swissinnovationlab/hardware_stm32_s3220/README.md

# hardware_stm32_s3220
STM32 based motherboard for AEDT
