swissinnovationlab/hardware_stm32_s3220/S3220B/Documentation/BOM S3220B(S3220B_A) 220808.xls

Bill of Materials |  |  | Swiss Innovation Lab+
Source Data From: |  | S3220B.PrjPcb
Project: |  | S3220B.PrjPcb
Variant: |  | S3220B_A
Creation Date: | 17/09/2021 | 16:08
Print Date: | 2022-08-09 | 12:21:25
Production Quantity: | 1
Currency | USD
Designator |  | Comment | Description | Footprint | Quantity | Supplier 1 | Supplier Part Number 1 | Currency | Price | Price per board
C1, C2, C7, C8, C10, C12, C14, C16, C18, C20, C23, C25, C29, C33, C41, C43, C44, C45, C47, C49, C50, C52, C53, C55, C56, C57, C58 |  | 100nF_50V | 0.1µF ±10% 50V Ceramic Capacitor X7R 0603 (1608 Metric) | C_0603 | 27 | Digi-Key | 445-1314-6-ND | $ | 0,01309 | $0.35
C3, C4 |  | 18pF_50V | 18pF ±5% 50V Ceramic Capacitor C0G, NP0 0603 (1608 Metric) | C_0603 | 2 | Digi-Key | 399-1052-1-ND | $ | 0,00974 | $0.02
C5, C6 |  | 12pF_50V | 12pF ±1% 50V Ceramic Capacitor C0G, NP0 0603 (1608 Metric) | C_0603 | 2 | Digi-Key | 1276-2175-1-ND | $ | 0,05153 | $0.10
C9, C11, C13, C15, C17, C19, C48, C51, C54 |  | 10uF_10V | 10µF ±10% 10V Ceramic Capacitor X5R 0603 (1608 Metric) | C_0603 | 9 | Digi-Key | 490-10474-1-ND | $ | 0,03994 | $0.36
C21, C26, C31, C39 |  | 22uF_6.3V | 22µF ±20% 6.3V Ceramic Capacitor X5R 0603 (1608 Metric) | C_0603 | 4 | Digi-Key | 1276-1193-1-ND | $ | 0,04566 | $0.18
C24 |  | 100pF_50V | 33pF ±1% 50V Ceramic Capacitor C0G, NP0 0603 (1608 Metric) | C_0603 | 1 | Digi-Key | 1276-2159-2-ND | $ | 0,04166 | $0.04
C30, C38 |  | 220uF_6.3V | 220µF ±20% 6.3V Ceramic Capacitor X5R 1206 (3216 Metric) | C_1206 | 2 | Digi-Key | 490-13970-1-ND | $ | 0,59945 | $1.20
C32, C40 |  | 1uF_50V | 1µF 50V Ceramic Capacitor X5R 0603 (1608 Metric) 0.063" L x 0.032" W (1.60mm x 0.80mm) | C_0603 | 2 | Digi-Key | 1276-1860-1-ND | $ | 0,03472 | $0.07
C34, C35, C36, C37, C42 |  | 33pF_50V | 33pF ±1% 50V Ceramic Capacitor C0G, NP0 0603 (1608 Metric) | C_0603 | 5 | Digi-Key | 1276-2262-6-ND | $ | 0,04166 | $0.21
C46 |  | 1.5pF_50V | 1.5pF ±0.1pF 50V Ceramic Capacitor C0G, NP0 0603 (1608 Metric) | C_0603 | 1 | Digi-Key | 1276-1071-1-ND | $ | 0,01291 | $0.01
CN1, CN3 |  | S2B-XH | Connector Header Through Hole, Right Angle 2 position 0.098" (2.50mm) | CN_S2B-XH-A | 2 | Digi-Key | 455-2257-ND | $ | 0,07792 | $0.16
CN2 |  | USB-C | USB-C (USB TYPE-C) USB 3.2 Gen 2 (USB 3.1 Gen 2, Superspeed + (USB 3.1)) Receptacle Connector 24 Position Surface Mount, Right Angle; Through Hole | CN_USB-C-RA_2 | 1 | Digi-Key | 2223-UJ31-CH-G-SMT-TR-67CT-ND | $ | 2,43252 | $2.43
CN7, CN8, CN9, CN11 |  | uFL | Ultra Miniature Coaxial Connector Jack, Male Pin 50 Ohm Surface Mount Solder | CN_RF_uFL | 4 | Digi-Key | A118077CT-ND | $ | 0,25410 | $1.02
CN10 |  | MicroSIM | 6 Position Card Connector Micro SIM Surface Mount, Right Angle Gold | CN_MicroSIM-Holder | 1 | Digi-Key | WM9786CT-ND | $ | 1,14178 | $1.14
D1 |  | LED_Green | Green 560nm LED Indication - Discrete 1.8V 2-SMD, Boomerang | LED_2-SMD_4x4 | 1 | Digi-Key | 475-1248-1-ND | $ | 0,10408 | $0.10
D2 |  | LED_Red | Red 630nm LED Indication - Discrete 1.8V 2-SMD, Boomerang | LED_2-SMD_4x4 | 1 | Digi-Key | 475-3123-1-ND | $ | 0,10626 | $0.11
D3 |  | LED_Yellow | Yellow 587nm LED Indication - Discrete 1.8V 2-SMD, Boomerang | LED_2-SMD_4x4 | 1 | Digi-Key | 475-1252-1-ND | $ | 0,11695 | $0.12
D4, D6, D7 |  | LED_Red | Red 631nm LED Indication - Discrete 2V 0603 | LED_0603 | 3 | Digi-Key | 160-1830-1-ND | $ | 0,07565 | $0.23
F1, F2 |  | 5.0A_63V | FUSE BOARD MNT 5A 63VAC/VDC 1206 | F_1206 | 2 | Digi-Key | 507-1194-1-ND | $ | 0,17995 | $0.36
FB1 |  | 68R_1A | FERRITE BEAD 68 OHM 0603 1LN | L_0603 | 1 | Digi-Key | 240-2372-1-ND | $ | 0,02658 | $0.03
K1 |  | Relay SPST | RELAY REED SIP SPST 0.5A 5V | K_REED-SIP-SPST | 1 | Digi-Key | 1835-1116-ND | $ | 0,63630 | $0.64
L1 |  | 47nH_300mA | 47nH Unshielded Multilayer Inductor 300mA 700 mOhm Max 0603 (1608 Metric) | L_0603 | 1 | Digi-Key | 587-1553-1-ND | $ | 0,03961 | $0.04
LS1 |  | SMT-1028-S-2-R | Buzzers Transducer, Externally Driven Electromechanical/Magnetic 3.6 V 100mA 2.83kHz 93dB @ 3.6V, 10cm Surface Mount Solder Pads | LS_SMT-1028-S-2-R | 1 | Digi-Key | 668-1531-1-ND | $ | 1,99500 | $2.00
PB1, PB2, PB3, PB4 |  | SPST | Tactile Switch SPST-NO Top Actuated Surface Mount | PB_PTS810 | 4 | Digi-Key | CKN10502DKR-ND | $ | 0,17302 | $0.69
Q1, Q2, Q3, Q4, Q5, Q13, Q16, Q17, Q18, Q19 |  | PMV65XPEAR | P-Channel 20V 2.8A (Ta) 480mW (Ta), 6.25W (Tc) Surface Mount TO-236AB (SOT23) | U_SOT23-3 | 10 | Digi-Key | 1727-2310-1-ND | $ | 0,11204 | $1.12
Q6, Q9, Q10, Q11, Q12 |  | DTC143 | Pre-Biased Bipolar Transistor (BJT) NPN - Pre-Biased 50V 100mA 200mW Surface Mount SC-75, SOT-416 | Q_SOT-416 | 5 | Digi-Key | DTC143ZET1GOSCT-ND | $ | 0.3 | $1.50 | replacement with transistors and resistors
Q7, Q8, Q14, Q15 |  | BC817 | Bipolar (BJT) Transistor NPN 100MHz 45V 0.5A SOT23 | Q_SOT23 | 4 | Digi-Key | 1727-2919-1-ND | $ | 0,02679 | $0.11
R1, R2, R3, R6, R7, R9, R13, R15, R27, R55, R66, R67, R70, R75, R80, R83, R84 |  | 1M | 1 MOhms ±1% 0.1W, 1/10W Chip Resistor 0603 (1608 Metric) Automotive AEC-Q200 Thick Film | R_0603 | 17 | Digi-Key | P1.00MHCT-ND | $ | 0,01264 | $0.21
R4, R5, R25, R47, R48, R50, R57, R58, R60, R78, R81, R82 |  | 10k | 10 kOhms ±1% 0.1W, 1/10W Chip Resistor 0603 (1608 Metric) Automotive AEC-Q200 Thick Film | R_0603 | 12 | Digi-Key | P10.0KHCT-ND | $ | 0,01449 | $0.17
R8, R16, R18, R19, R28, R29, R30, R32, R46, R68, R69, R71, R72, R73, R74, R76 |  | 68 | 68 Ohms ±1% 0.1W, 1/10W Chip Resistor 0603 (1608 Metric) Automotive AEC-Q200 Thick Film | R_0603 | 16 | Digi-Key | P68.0HCT-ND | $ | 0,01449 | $0.23
R10, R11, R12 |  | 620 | 620 Ohms ±1% 0.1W, 1/10W Chip Resistor 0603 (1608 Metric) Automotive AEC-Q200 Thick Film | R_0603 | 3 | Digi-Key | P620HCT-ND | $ | 0,01273 | $0.04
R14, R21, R23, R24, R26, R34, R38, R39, R42, R64 |  | 0 | 0 Ohms Jumper 0.1W, 1/10W Chip Resistor 0603 (1608 Metric) Automotive AEC-Q200 Thick Film | R_0603 | 10 | Digi-Key | P0.0GCT-ND | $ | 0,00962 | $0.10
R20, R22, R77 |  | 1k | 1 kOhms ±1% 0.1W, 1/10W Chip Resistor 0603 (1608 Metric) Automotive AEC-Q200 Thick Film | R_0603 | 3 | Digi-Key | P1.00KHCT-ND | $ | 0,01153 | $0.03
R31 |  | 10 | 10 Ohms ±1% 0.1W, 1/10W Chip Resistor 0603 (1608 Metric) Automotive AEC-Q200 Thick Film | R_0603 | 1 | Digi-Key | P10.0HCT-ND | $ | 0,01153 | $0.01
R40, R41, R43 |  | 22 | 22 Ohms ±1% 0.1W, 1/10W Chip Resistor 0603 (1608 Metric) Automotive AEC-Q200 Thick Film | R_0603 | 3 | Digi-Key | P22.0HCT-ND | $ | 0,01153 | $0.03
R44 |  | 15k | 15 kOhms ±1% 0.1W, 1/10W Chip Resistor 0603 (1608 Metric) Automotive AEC-Q200, Moisture Resistant Thick Film | R_0603 | 1 | Digi-Key | YAG3569DKR-ND | $ | 0,00527 | $0.01
R49, R51, R54, R56, R59, R61 |  | 4k7 | 4.7 kOhms ±1% 0.1W, 1/10W Chip Resistor 0603 (1608 Metric) Automotive AEC-Q200 Thick Film | R_0603 | 6 | Digi-Key | P4.70KHCT-ND | $ | 0,00670 | $0.04
R52, R53, R62, R63 |  | 47k | 47 kOhms ±1% 0.1W, 1/10W Chip Resistor 0603 (1608 Metric) Automotive AEC-Q200 Thick Film | R_0603 | 4 | Digi-Key | P47.0KHCT-ND | $ | 0,00670 | $0.03
R79 |  | 100k | 100 kOhms ±1% 0.1W, 1/10W Chip Resistor 0603 (1608 Metric) Automotive AEC-Q200 Thick Film | R_0603 | 1 | Digi-Key | P100KHCT-ND | $ | 0,01367 | $0.01
U1 |  | USBLC6 | TVS DIODE 5.25V 17V SOT23-6 | U_SOT23-6 | 1 | Digi-Key | 497-11882-6-ND | $ | 0 | $0.00 | removed
U2 |  | STM32L476VGT6 | ARM® Cortex®-M4 STM32L4 Microcontroller IC 32-Bit 80MHz 1MB (1M x 8) FLASH 100-LQFP (14x14) | U_100-LQFP | 1 | Digi-Key | 497-15873-ND | $ | 14.9 | $14.90 | new price from DigiKey
U3, U4 |  | TPS22917 | Power Switch/Driver 1:1 P-Channel 2A SOT-23-6 | U_SOT23-6 | 2 | Digi-Key | 296-50498-1-ND | $ | 0.3 | $0.60 | replacement with transistors and resistors
U6 |  | SRV05-4HTG | TVS DIODE 6V 15V SOT23-6 | U_SOT23-6 | 1 | Digi-Key | F4204CT-ND | $ | 0 | $0.00 | removed
U7 |  | BG95-M3 | MultiBand, 3GPP Rel.13, LTE Cat.M1/NB1, GSM/EGPRS, 3xUART, VoLTE | U_BG96_BG95 | 1 | Codico | BG95-M3 | $ | 13 | $13.00 | price from Pero
U8, U9 |  | TXB0104 | Voltage Level Translator Bidirectional 1 Circuit 4 Channel 100Mbps 14-VQFN (3.5x3.5) | U_14-VQFN | 2 | Digi-Key | 296-21930-6-ND | $ | 1.29 | $2.58 | replacement with another variant
U10 |  | NINA-B301 | MOD BLE 4.2 NORDIC NRF52840 SOC | U_NINA-B301 | 1 | uBlox | NINA-B301 | $ | 15.5 | $15.50 | price for NINA-B316
U11 |  | SAM-M8Q | SAM-M8Q RF Receiver Galileo, GLONASS, GPS 1.575GHz, 1.602GHz -165dBm 400kbps | U_SAM-M8Q | 1 | Digi-Key | 672-1054-1-ND | $ | 22 | $22.00 | price from Pero
U12 |  | M24C32 | EEPROM Memory IC 32Kb (4K x 8) I2C 1MHz 450ns 8-SO | U_8-SOIC_3.9 | 1 | Digi-Key | 497-5027-1-ND | $ | 0.27 | $0.27 | replacement with another variant
U13 |  | BME280 | Humidity Temperature Sensor 0 ~ 100% RH I2C, SPI ±3% 1s Surface Mount | U_BME280 | 1 | Digi-Key | 828-1063-1-ND | $ | 9 | $9.00 | new price from DigiKey
U14 |  | MMA8452 | Accelerometer X, Y, Z Axis ±2g, 4g, 8g 0.78Hz ~ 400Hz 16-QFN (3x3) | U_16-QFN-5X3 | 1 | Digi-Key | MMA8452QT-ND | $ | 4.4 | $4.40 | price from Mouser
U15 |  | TS3A5018 | 4 Circuit IC Switch 2:1 10Ohm 16-UQFN (2.6x1.8) | U_16-VFQFN | 1 | Digi-Key | 296-19899-1-ND | $ | 0.91 | $0.91 | new price from DigiKey
U16 |  | W25Q32 | FLASH - NOR Memory IC 32Mb (4M x 8) SPI - Quad I/O 133MHz 8-SOIC | U_8-SOIC_5.3 | 1 | Digi-Key | W25Q32JVSSIQ-ND | $ | 6 | $6.00 | 64MB variant
Y1 |  | 8MHz | 8MHz ±20ppm Crystal 18pF 72 Ohms 4-SMD, No Lead | Y_ABMM2 | 1 | Digi-Key | 535-9628-1-ND | $ | 0,49500 | $0.49
Y2 |  | 32.768kHz | 32.768kHz ±10ppm Crystal 12.5pF 70 kOhms 2-SMD, No Lead | Y_XTAL-3215 | 1 | Digi-Key | XC1968CT-ND | $ | 0,42900 | $0.43
 |  |  |  |  | 192 |  |  |  |  | $105.33
Approved |  | Notes
