swissinnovationlab/hardware_stm32_s3220/(list of files, drawings)

Other design files:
S3220A/Source/S3220A1.SchDoc
S3220A/Source/S3220A2.SchDoc
S3220A/Source/S3220A3.SchDoc
S3220A/Source/S3220A4.SchDoc
S3220A/Source/S3220A.PrjPcb
S3220B/Source/Panelized_S3220B.PcbDoc
S3220B/Source/S3220B1.SchDoc
S3220B/Source/S3220B2.SchDoc
S3220B/Source/S3220B3.SchDoc
S3220B/Source/S3220B4.SchDoc
S3220B/Source/S3220B.PrjPcb
