swissinnovationlab/hardware_stm32_s3220/(commit log)

2020-10-09 Create project files
    [Panelized_S3220A.PcbDoc, S3220A.PrjPcb, S3220A1.SchDoc, S3220A2.SchDoc, S3220A3.SchDoc, S3220A4.SchDoc, S3220A5.SchDoc]
2020-10-09 Update project container with variant, update CPU and BLE sheets
    [S3220A.PrjPcb, S3220A2.SchDoc, S3220A5.SchDoc]
2020-10-09 Update all sheets parameters
    [S3220A1.SchDoc, S3220A2.SchDoc, S3220A3.SchDoc, S3220A4.SchDoc, S3220A5.SchDoc]
2020-10-09 Add GPS, update GPU and peripherals wiring
    [Panelized_S3220A.PcbDoc, S3220A.PrjPcb, S3220A2.SchDoc, S3220A4.SchDoc]
2020-10-09 Update GPU connections, reannotate everything
    [S3220A1.SchDoc, S3220A2.SchDoc, S3220A3.SchDoc, S3220A4.SchDoc, S3220A5.SchDoc]
2020-10-09 Multiplex CPU connections
    [S3220A2.SchDoc, S3220A4.SchDoc]
2020-10-23 Update project files, remove module sheet
    [S3220A.PrjPcb, S3220A1.SchDoc, S3220A4.SchDoc, S3220A5.SchDoc]
2020-10-23 Replace STM with L746 variant, add USB C wiring
    [S3220A1.SchDoc, S3220A2.SchDoc]
2020-10-23 Annotate components for CPU, add battery measurement from MPL
    [S3220A2.SchDoc]
2020-10-28 Add CPU to BLE and FLASH wiring, rename UART, I2C and SPI wires
    [S3220A.PrjPcb, S3220A2.SchDoc, S3220A4.SchDoc]
2020-10-28 Connect modem wiring to CPU, only UART
    [S3220A2.SchDoc, S3220A3.SchDoc, S3220A4.SchDoc]
2020-10-28 Add control wiring to CPU and modem
    [S3220A1.SchDoc, S3220A2.SchDoc, S3220A3.SchDoc]
2020-10-28 Update annotation of components on all sheets
    [S3220A1.SchDoc, S3220A2.SchDoc, S3220A3.SchDoc, S3220A4.SchDoc]
2020-10-28 Update BLE control pins, add modem control pins, remove old control pins from BLE
    [S3220A1.SchDoc, S3220A2.SchDoc, S3220A3.SchDoc, S3220A4.SchDoc]
2020-10-28 Update CPU USB wiring, add module M1 wiring
    [S3220A1.SchDoc, S3220A2.SchDoc, S3220A3.SchDoc]
2020-10-28 Add flash control, move I2C2 to external connector for external board
    [S3220A1.SchDoc, S3220A2.SchDoc]
2020-10-29 Add USB C power control
    [S3220A1.SchDoc, S3220A2.SchDoc]
2020-10-29 Reorder battery connection and USB C pins
    [S3220A1.SchDoc]
2020-10-29 Add USB C polarity control and detection
    [S3220A1.SchDoc, S3220A2.SchDoc]
2020-10-29 Add battery measurement and USB C power detection circuits
    [S3220A1.SchDoc, S3220A2.SchDoc]
2020-10-29 Rearrange sheet 1, add control of CC LED, add VBUS measurement
    [S3220A1.SchDoc, S3220A4.SchDoc]
2020-10-29 Add modem power control and level shifter enable control
    [S3220A.PrjPcb, S3220A1.SchDoc, S3220A2.SchDoc, S3220A3.SchDoc]
2020-10-29 Update modem wiring, update annotation of all components
    [S3220A.PrjPcb, S3220A1.SchDoc, S3220A2.SchDoc, S3220A3.SchDoc, S3220A4.SchDoc]
2020-10-29 Add CC LED and update annotation
    [S3220A1.SchDoc, S3220A2.SchDoc, S3220A3.SchDoc, S3220A4.SchDoc]
2020-10-30 Change polarity of CC pin, add PWM ability to CC led
    [S3220A1.SchDoc, S3220A2.SchDoc]
2020-10-30 Add NINA USB capability, add GPS backup power supply control to CPU, reannotate everything
    [S3220A.PrjPcb, S3220A1.SchDoc, S3220A2.SchDoc, S3220A3.SchDoc, S3220A4.SchDoc]
2020-10-30 Update modem version to Quectel BG95-M3
    [S3220A3.SchDoc]
2020-10-30 Update CC LED polarity and resistor value
    [S3220A1.SchDoc, S3220A2.SchDoc]
2020-10-30 Update CC LED control to correct value
    [S3220A1.SchDoc, S3220A2.SchDoc]
2020-11-02 Add CC resistors, reannotate everything
    [S3220A.PrjPcb, S3220A2.SchDoc, S3220A3.SchDoc, S3220A4.SchDoc]
2020-11-02 Import changes to PCB, move top overlay designators to M5
2020-11-02 Position battery 1 and 2 with their clips
2020-11-02 Place and route CPU blocking capacitors, place and route CPU clock crystals
2020-11-02 Place and route analog ground components and filtering, route GPS UART traces
2020-11-02 Route FLASH MUX traces, route CPU FLASH SPI
2020-11-03 Mux BLE and CPU on FLASH
    [S3220A4.SchDoc]
2020-11-03 Route FLASH, position I2C1 components, add I2C1 pullups
    [S3220A4.SchDoc]
2020-11-03 Place and route part of I2C1 components
2020-11-03 Place and route environment sensor and accelerometer
2020-11-03 Route CPU to BLE communication and control traces
2020-11-03 Update GPS control wiring, route USB to NINA connections
    [S3220A2.SchDoc]
2020-11-03 Add I2C2 pullups, route Module M1 traces
    [S3220A2.SchDoc]
2020-11-03 Shuffle CPU pins for easier routing, route module control pins, place GPS power control circuit
    [S3220A2.SchDoc]
2020-11-03 Shuffle Module and GPS power control pins on CPU for easier routing
    [S3220A2.SchDoc]
2020-11-03 Place and rounte GPS power control circuit
2020-11-03 Route I2C2 traces to Module
2020-11-03 Place and partialy route CPU pushbutton and LED
2020-11-03 Route CPU programming traces
2020-11-04 Add VBUS C power control, route CPU programming port
    [S3220A1.SchDoc, S3220A2.SchDoc]
2020-11-04 Update modem power control wiring, update positon of modem signaling components
    [S3220A2.SchDoc]
2020-11-04 Place and route CPU to modem UART traces, place modem control components and route
    [S3220A2.SchDoc]
2020-11-04 MUX CPU connections for module power control, place and route modem control circuitry
    [S3220A2.SchDoc, S3220A3.SchDoc]
2020-11-04 Route modem USB and debug UART traces
2020-11-04 Route modem supply switch and surrounding components
2020-11-05 Route modem power supply, move flash and reroute, place and route BLE pushbutton and LED
    [S3220A2.SchDoc]
2020-11-05 Place and route BLE pushbutton and LED on new position, update VDD_EXD filtering component placement and routing
    [S3220A2.SchDoc, S3220A4.SchDoc]
2020-11-05 Update module I2C2 routing and VBUS detection routing
2020-11-05 Place and route QWIIC components, route USB to CPU traces
2020-11-05 Place and route part of USB C connector
    [S3220A1.SchDoc]
2020-11-05 Route USB C module I2C2 components and traces, route ePaper on module traces
2020-11-05 Route USB C power control
2020-11-05 VBUS_AIN to USB VBUS resistor route
2020-11-06 Place and route QWIIC, place and route relay and battery connections
    [S3220A1.SchDoc]
2020-11-06 Clean junk traces and overlay designations
2020-11-06 Update designator position on sheet, add routing tool on curves of PCB, partial route of conducting edge
    [S3220A.PrjPcb, S3220A2.SchDoc]
2020-11-06 Add ground ring on the PCB both bottom and top stop mask layers
    [S3220A4.SchDoc]
2020-11-06 Add CPU current measurement circuit, add test points bottom overlay designators
    [S3220A2.SchDoc, S3220A3.SchDoc, S3220A4.SchDoc]
2020-11-06 Add CPU current measuring to PCB, update guidlines and remove old
2020-11-06 Update project variant, update active BOM, change polygon pour clearence type
    [S3220A.PrjPcb]
2020-11-06 Update CPU VDD, import to PCB and update polygon poors, resolve DRC errors
    [S3220A2.SchDoc]
2020-11-06 Fix USB C connector footprint problem, update all footprints from libraries
2020-11-09 Add battery capacitors, reannotate everyting, add antenna via stitching, add CPU current measurement polygon cutout
    [S3220A1.SchDoc, S3220A2.SchDoc, S3220A3.SchDoc, S3220A4.SchDoc]
2020-11-09 Update designators, update panel size and panel production documentation
    [Panelized_S3220A.PcbDoc]
2020-11-09 Update project variant
    [S3220A.PrjPcb]
2020-11-09 Update active BOM
2020-11-10 Update schematic with new accelerometer and add INT2 connection to CPU
    [S3220A2.SchDoc, S3220A4.SchDoc]
2020-11-10 Update accelerometer and routing, update VIA stitching, update polygon pours
2020-11-12 Update LED CC control, replace USB C connector with mid PCB type
    [S3220A.PrjPcb]
2020-11-12 Revert "Update LED CC control, replace USB C connector with mid PCB type"
    This reverts commit da84b45dd6944223286c9bfe337bcef2c92827cd.
    [S3220A.PrjPcb]
2021-05-03 Create project revision S3220B
    [Panelized_S3220B.PcbDoc, S3220B.PrjPcb, S3220B1.SchDoc, S3220B2.SchDoc, S3220B3.SchDoc, S3220B4.SchDoc]
2021-06-18 Update battery connections
    [S3220B1.SchDoc]
2021-06-18 Update annotation, replace Takachi enclosure, import changes to PCB and update board outline
    [S3220B.PrjPcb, S3220B1.SchDoc, S3220B4.SchDoc]
2021-06-18 Update PCB outline, place batteries
    [S3220B4.SchDoc]
2021-06-25 Update component placement, update component layers, remove double sided mounting preferences, update annotation of all components, import all updates to PCB
2021-06-29 Update BOM variant, update output generation file
    [S3220B.PrjPcb, S3220B1.SchDoc]
2021-06-30 Update PCB routing of modem components, update placing of memory
2021-07-21 Add buzzer and control circuit
    [S3220B.PrjPcb, S3220B2.SchDoc]
2021-07-28 Update EPD components, update USB components, update BOM variant update active BOM
    [S3220B.PrjPcb, S3220B1.SchDoc, S3220B2.SchDoc, S3220B4.SchDoc]
2021-07-28 Add programming interface template, update analog and reference voltage dividing
    [S3220B.PrjPcb, S3220B1.SchDoc, S3220B2.SchDoc, S3220B4.SchDoc]
2021-07-28 Update case, update annotation and import to PCB, redefine PCB shape
    [S3220B.PrjPcb, S3220B1.SchDoc, S3220B2.SchDoc, S3220B4.SchDoc]
2021-07-28 Add RFID module with surrounding components, connect RFID to CPU
    [S3220B2.SchDoc, S3220B4.SchDoc]
2021-07-30 Update relays, update annotation in schematic, import to PCB and update placement and routing
    [S3220B.PrjPcb, S3220B1.SchDoc, S3220B2.SchDoc, S3220B4.SchDoc]
2021-07-30 Update annotation of all components, place relays
    [S3220B.PrjPcb, S3220B1.SchDoc, S3220B2.SchDoc, S3220B3.SchDoc, S3220B4.SchDoc]
2021-07-30 Update modem components placement and routing
    [S3220B.PrjPcb, S3220B4.SchDoc]
2021-08-12 Add GPS active antenna interface, update PCB routing and placement
    [S3220B.PrjPcb, S3220B3.SchDoc]
2021-08-12 Route RFID SPI traces
    [S3220B.PrjPcb]
2021-08-12 Route CPU to modem and BLE control tracks
    [S3220B2.SchDoc]
2021-08-27 Remove second reed relay, update RGB sensor connector
    [S3220B1.SchDoc, S3220B2.SchDoc]
2021-08-27 Update modem SIM card routing
    [S3220B.PrjPcb, S3220B4.SchDoc]
2021-08-27 Shuffle CPU pinout and wiring, update modem control traces and routing
    [S3220B2.SchDoc]
2021-08-30 Update Quectel GNSS UART components, update PCB
    [S3220B2.SchDoc, S3220B3.SchDoc]
2021-08-30 Route CPU to Quectel GNSS components
    [S3220B3.SchDoc]
2021-08-30 Route uBlox GPS and its components
    [S3220B2.SchDoc]
2021-08-31 Place and route modem to CPU communaction traces
    [S3220B2.SchDoc, S3220B3.SchDoc]
2021-08-31 Update CPU routing
    [S3220B2.SchDoc]
2021-09-01 Update BLE programmer and RFID routing
    [S3220B2.SchDoc]
2021-09-02 Update CPU to USB placement and routing, update CPU programmer routing
    [S3220B2.SchDoc]
2021-09-03 Update sensors and memories placement and routing
    [S3220B4.SchDoc]
2021-09-03 Update M5 layer, update GND ring
2021-09-03 Repour all polygon pours, update polygon sizes to match PCB
2021-09-04 Run DRC and fix remaining errors, repour all polygons, update active GPS antenna positioning and inclination
    [S3220B.PrjPcb]
2021-09-17 Update annotation of all components, update M5 layer, update active antenna positioning, update DRC and polygon pours
    [Panelized_S3220B.PcbDoc, S3220B.PrjPcb, S3220B1.SchDoc, S3220B2.SchDoc, S3220B3.SchDoc, S3220B4.SchDoc]
2021-09-22 Replace 4MB flash memory with 8MB variant
    [S3220B.PrjPcb, S3220B4.SchDoc]
2021-09-22 Update reed relay component, update polygon pours and via stitching, run DRC
    [S3220B.PrjPcb, S3220B1.SchDoc]
2021-09-22 Remove copper planes from reed relay, update via stitching and layers M5 and M6
2022-08-24 Add BOM comparison table
    [BOM S3220B(S3220B_A) 220808.xls]
2022-08-24 Update USB wiring and position of USB-C connector, update buzzer position
    [S3220B2.SchDoc]
2022-08-25 Replace relay with three pole switch, update PCB components and rearrange connectors
    [S3220B.PrjPcb, S3220B1.SchDoc, S3220B2.SchDoc]
2022-08-26 Add MicroSD card and surrounding components
    [S3220B1.SchDoc]
2022-08-26 Add MicroSD with SPI wiring, pull resistors and bus deringing
    [S3220B1.SchDoc]
2022-08-30 Update PCB with changes in schematic, place MicroSD holder and SIM card holder on bottom layer
    [S3220B1.SchDoc, S3220B4.SchDoc]
2022-09-02 Replace NINA-B301 with NINA-B316, update MicroSD card holder and Flash memory size
    [S3220B.PrjPcb, S3220B4.SchDoc]
2022-09-05 Replace power switches with transistors and GNSS transistors with integrated transistors, update annotation and block sheet positioning
    [S3220B.PrjPcb, S3220B1.SchDoc, S3220B2.SchDoc, S3220B3.SchDoc, S3220B4.SchDoc]
2022-09-06 Replace level shifter for modem with available component
    [S3220B3.SchDoc, S3220B4.SchDoc]
2022-09-07 Update STM wiring
    [S3220B1.SchDoc, S3220B2.SchDoc, S3220B3.SchDoc]
2022-09-08 Redefine CPU connections
    [S3220B1.SchDoc, S3220B2.SchDoc, S3220B4.SchDoc]
2022-09-08 Update wiring with old diagram
    [S3220B1.SchDoc, S3220B2.SchDoc]
2022-09-08 Update module wiring and import changes to PCB
    [S3220B1.SchDoc, S3220B2.SchDoc]
2022-09-08 Update microSD card wiring
    [S3220B1.SchDoc, S3220B2.SchDoc]
2022-09-08 Place and route modem control circuitry
2022-09-09 Update MCU wiring and PCB routing
    [S3220B2.SchDoc]
2022-09-09 Update STM32 wiring and routing
    [S3220B2.SchDoc]
2022-09-09 Update USB and QWIIC routing
    [S3220B2.SchDoc]
2022-09-09 Update modem components placement and routing, update switch, module, BLE routing
2022-09-10 Update NINA and flash routing and positioning
    [S3220B.PrjPcb]
2022-09-11 Update BLE placement and routing
    [S3220B4.SchDoc]
2022-09-11 Reset and update all annotation, import to PCB and rerun DRC
    [S3220B.PrjPcb, S3220B1.SchDoc, S3220B2.SchDoc, S3220B3.SchDoc, S3220B4.SchDoc]
2022-09-11 Update all TP silkscreen
2022-09-11 Update PCB DRC
2022-09-11 Move signal traces to move ground polygons
2022-09-12 Replace transisotrs with doides, update polygon pours and via stitching
    [S3220B.PrjPcb, S3220B1.SchDoc]
2022-09-13 Update STM32 wire name, update BOM variant
    [S3220B.PrjPcb, S3220B2.SchDoc]
2022-09-13 Add no ERC symbol to schematic, update BOM variant
    [S3220B.PrjPcb, S3220B1.SchDoc]
2022-09-15 Optimize wire names and location, update buzzer and USB connector locations, repour all polygons, add via stitching and run DRC
    [S3220B.PrjPcb, S3220B1.SchDoc, S3220B2.SchDoc]
2022-09-15 Update modem LED position
2022-09-15 Update M5 layer, update panelization for minimal waste
    [Panelized_S3220B.PcbDoc]
2022-09-16 Replace NIINA-B316 with NINA-B301
    [S3220B.PrjPcb, S3220B4.SchDoc]
2022-09-19 Update active BOM, update BOM variant, run DRC
    [S3220B.PrjPcb]
2022-09-19 Replace modem transistors with available ones, move GNSS pins to level shifter
    [S3220B.PrjPcb, S3220B3.SchDoc]
2022-10-20 Add RFID capacitors, update all annotations, update all polygon pours, rerun DRC and regenerate manufacturing output job container
    [S3220B.PrjPcb, S3220B1.SchDoc, S3220B2.SchDoc, S3220B3.SchDoc, S3220B4.SchDoc]
